neilrqm/guitar-tuner/README.md

guitar-tuner
============

Design files and source code for a stroboscopic guitar tuner.

The design files are in the pcb/ directory.  To view the project, 
open the tuner.pro file in KiCAD (http://www.kicad-pcb.org/).

The source code is in the src/ directory.  It's pretty buggy.
