neilrqm/guitar-tuner/pcb/tuner.kicad_pcb

## KiCad design pcb/tuner.kicad_pcb (2014-02-09)

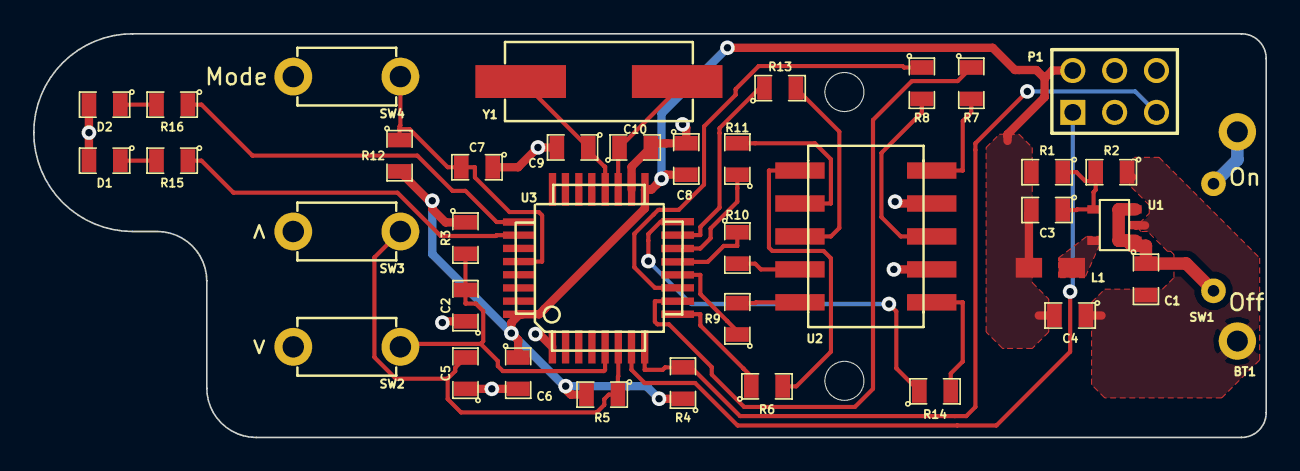
[picture p1: board tuner.kicad_pcb from above]

Board: 2 copper layers, 74.8 x 24.5 mm, 39 parts (1 on the bottom side), 33 nets.

Parts:
BT1: BATTERY
C1, C4: 10 uF; SM0805
C2, C5, C6, C7, C8: 100 nF; SM0805
C3: 22 pF; SM0805
C9: 25 pF; SM0805
C10: 27 pF; SM0805
D1, D2: LED; SM0805
L1: 2.2 uH; SM1008
P1: PDI; pin_array_3x2
R1: 420 K; SM0805
R2: 180 K; SM0805
R3, R4, R5, R12: 10 K; SM0805
R6, R7, R8, R9, R10, R11, R13, R14: 27 Ohms; SM0805
R15, R16: 18 Ohms; SM0805
SW1: SPST; DIP1
SW2: <; SWITCH_YAY
SW3: >; SWITCH_YAY
SW4: Mode; SWITCH_YAY
U1: TPS62240; SOT23-5-2
U2: NKR131SB; LED_DISPLAY
U3: ATXMEGA8E5; TQFP32-2
Y1: 8 MHz; CRYSTAL_SMD

Connections:
GND: BT1.2, C1.2, C2.1, C4.1, C5.1, C6.2, C7.1, C8.1, C9.2, C10.2, D1.2, D2.2, P1.6, R2.1, SW2.1, SW3.1, SW4.1, U1.2, U2.7, U2.9, U3.1, U3.18
unnamed: R7.1, U3.10
unnamed: R11.1, U3.14
unnamed: R10.1, U3.13
unnamed: R9.1, U3.12
unnamed: R8.1, U3.11
unnamed: R6.1, U3.9
unnamed: R14.2, U2.6
unnamed: R13.2, U2.3
unnamed: D2.1, R16.2
unnamed: R16.1, U3.25
unnamed: R15.1, U3.26
unnamed: D1.1, R15.2
unnamed: R14.1, U3.16
unnamed: R13.1, U3.15
unnamed: R6.2, U2.1
unnamed: R9.2, U2.5
unnamed: R11.2, U2.2
unnamed: R10.2, U2.4
unnamed: R8.2, U2.8
unnamed: R7.2, U2.10
unnamed: C2.2, R3.2, SW2.2, U3.5
unnamed: C5.2, R5.1, SW3.2, U3.6
unnamed: P1.5, R4.2, U3.8
unnamed: P1.1, U3.7
unnamed: C3.1, R1.1, R2.2, U1.4
unnamed: L1.1, U1.5
unnamed: C1.1, SW1.2, U1.1, U1.3
unnamed: BT1.1, SW1.1
unnamed: C9.1, U3.20, Y1.2
unnamed: C7.2, R12.1, SW4.2, U3.28
unnamed: C10.1, U3.19, Y1.1
VDD: C3.2, C4.2, C6.1, C8.2, L1.2, P1.2, R1.2, R3.1, R4.1, R5.2, R12.2, U3.17, U3.32
