neilrqm/guitar-tuner/(commit log)

2014-01-29 Added hardware source files
    [tuner.kicad_pcb, tuner.sch]
2014-01-30 Mostly finished layout.
    [tuner.kicad_pcb, tuner.sch]
2014-01-30 Added gerber files.
    [tuner.csv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]
2014-01-30 No change...
    [tuner.sch]
2014-01-31 - Generated traces - Changed battery holder mounting holes to non-plated through holes and modified the drill file accordingly. - Re-generated output files.
    [tuner-B_Cu.gbl, tuner-B_Mask.gbs, tuner-B_SilkS.gbo, tuner-Edge_Cuts.gbr, tuner-F_Cu.gtl, tuner-F_Mask.gts, tuner-F_SilkS.gto, tuner.drl]
2014-02-01 Rearranged layout to be more compact, reduced board length.
    [tuner-B_Cu.gbl, tuner-B_Mask.gbs, tuner-B_SilkS.gbo, tuner-Edge_Cuts.gbr, tuner-F_Cu.gtl, tuner-F_Mask.gts, tuner-F_SilkS.gto, tuner.drl]
2014-02-08 Swapped the LEDs to avoid crossing wires, tweaked some stuff, added a ground plane.
    [tuner.kicad_pcb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]
2014-02-09 Final tweaks to PCB layout, added CC BY-SA license. This commit corresponds to the initial PCB run.
    [tuner-B_Cu.gbl, tuner-B_Mask.gbs, tuner-B_SilkS.gbo, tuner-Edge_Cuts.gbr, tuner-F_Cu.gtl, tuner-F_Mask.gts, tuner-F_SilkS.gto, tuner.drl]
2014-02-28 - Added manufacturer, part number, and description fields to BOM - Changed MCU info to an equivalent that is available
    [tuner.csv, tuner.sch]
2014-03-07 Added config code and LED defines.
2014-03-19 A bunch of code fixes to make it kind of work.
    [guitar-tuner.c, tuner.h]
2016-10-09 - Converted hardware design files to KiCAD 4.x format - Created footprints for new parts in r3 hardware design - Revised schematic and footprint associations for r3 hardware design
    [tuner-B_Cu.gbl, tuner-B_Mask.gbs, tuner-B_SilkS.gbo, tuner-Edge_Cuts.gbr, tuner-F_Cu.gtl, tuner-F_Mask.gts, tuner-F_SilkS.gto, tuner.drl]
