neilrqm/guitar-tuner/(notices)

Notices in the files:
pcb/tuner.kicad_pcb:
CC BY-SA License: http://creativecommons.org/licenses/by-sa/4.0/legalcode
CC BY-SA 4.0
